MohamedAminDridi/AquaVerse/(commit log)

2026-06-11 valve ACK retry
2026-06-11 valve retry: newest click cancels older loop
2026-06-12 valve button pending state - locks until device confirms
